Mflash777/starbiestonks/Renders/README.md

# Renders

- `schematic.png`, `schmaticsketch.jpeg`: the KiCad schematic and a sketch of it
- `kitcar2dfullpagepcb.jpeg`, `kitcar2dsmall.jpeg`: the routed PCB layout (2D)
- `kitcar3dviewgreenflat.jpeg`, `kitcarbirdseye.jpeg`: KiCad 3D viewer renders
