Mflash777/starbiestonks/BOM.md

# StarbieStonks – bill of materials

<!-- Generated by Half Life from project cmuwkw9wl08ms01oslrcru6od. Edits here are overwritten on the next sync. -->
<!-- Generated: 2026-10-12T04:02:59.856Z -->

> [!NOTE]
> This parts list is mirrored from [Half Life](https://halflife.hackclub.com). Editing it here will not change the platform's copy, and the next sync overwrites this file.

| Week | Tier | Parts funding |
| --- | --- | --- |
| Week 1 | Tier 2 | $65.00 |

| Part | What it's for | Qty | Unit | Total | Vendor |
| --- | --- | --- | --- | --- | --- |
| [XIAO ESP32-C3](https://www.seeedstudio.com/Seeed-XIAO-ESP32C3-p-5431.html) | Wi-Fi and the main loop | 1 | $4.99 | $4.99 | [Seeed Studio](https://www.seeedstudio.com/Seeed-XIAO-ESP32C3-p-5431.html) |
| [0.96 OLED (SSD1306 I2C)](https://www.amazon.com/dp/B0GBVWBWCR) | Shows the pet, menu, stats and stock screen | 1 | $9.99 | $9.99 | [Amazon](https://www.amazon.com/dp/B0GBVWBWCR) |
| [MPU6050](https://www.amazon.com/MPU-6050-Accelerometer-Gyroscope-Converter-Interface/dp/B0HDTWF4XQ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) | Detects tilt and shake to control the menu and pet reactions | 1 | $2.29 | $2.29 | [Amazon](https://www.amazon.com/MPU-6050-Accelerometer-Gyroscope-Converter-Interface/dp/B0HDTWF4XQ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) |
| [DHT11](https://www.amazon.com/Temperature-Humidity-Digital-3-3V-5V-Raspberry/dp/B07WT2HJ4F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) | Reads temperature and humidity for the stats screen | 1 | $5.99 | $5.99 | [Amazon](https://www.amazon.com/Temperature-Humidity-Digital-3-3V-5V-Raspberry/dp/B07WT2HJ4F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) |
| [MX Switches](https://www.amazon.com/Clicky-Mechanical-Keyboard-Switches-Tactile/dp/B0GX1XNZKB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) | Button 1 (menu / next ticker) and Button 2 (switch screens) | 1 | $4.99 | $4.99 | [Amazon](https://www.amazon.com/Clicky-Mechanical-Keyboard-Switches-Tactile/dp/B0GX1XNZKB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) |
| [Keycaps](https://www.amazon.com/Mechkeeb-Profile-Switches-Keyboard-Replacement/dp/B0BWDTBF1L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) | Caps for the two switches | 1 | $8.99 | $8.99 | [Amazon](https://www.amazon.com/Mechkeeb-Profile-Switches-Keyboard-Replacement/dp/B0BWDTBF1L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) |
| [10k Resistor](https://www.amazon.com/dp/B0B4JFPHTW) | Pull-up resistor for the DHT11 data line | 1 | $4.97 | $4.97 | [Amazon](https://www.amazon.com/dp/B0B4JFPHTW) |
| [PCB](https://www.jlcpcb.com/) | Custom board that holds and connects everything, made by JLCPCB | 1 | $5.30 | $5.30 | [JLCPCB](https://www.jlcpcb.com/) |
| [10PCS 2.54mm 40 Pin Breakaway Male Female Header Pins](https://www.amazon.com/Neprift-2-54mm-Breakaway-Female-Header/dp/B0GX55WYSX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) | to attach and detach parts so it is modular | 1 | $4.59 | $4.59 | [amazon](https://www.amazon.com/Neprift-2-54mm-Breakaway-Female-Header/dp/B0GX55WYSX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) |
| [passive buzzer](https://www.amazon.com/Shutao-12MMx8-5MM-Passive-Buzzer-Resistance/dp/B0GKNH6FPR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) | for sound | 1 | $5.99 | $5.99 | [amazon](https://www.amazon.com/Shutao-12MMx8-5MM-Passive-Buzzer-Resistance/dp/B0GKNH6FPR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) |
| **Parts subtotal** | — | — | — | **$58.09** | — |
| **Tax & shipping** | — | — | — | **$7.38** | — |
| **Total** | — | — | — | **$65.47** | — |

**$0.47 over the tier's funding.** Every tier gives a fixed amount for parts, so this needs cutting back or a higher tier.
