Mflash777/starbiestonks/BOM.csv

Item | Amount | Cost (ea.) | Total | Vendor | Link
XIAO ESP32-C3 | 1 | 4.99 | 4.99 | Seeed Studio | https://www.seeedstudio.com/Seeed-XIAO-ESP32C3-p-5431.html
0.96 OLED (SSD1306 I2C) | 1 | 9.99 | 9.99 | Amazon | https://www.amazon.com/dp/B0GBVWBWCR
MPU6050 | 1 | 2.29 | 2.29 | Amazon | https://www.amazon.com/dp/B0HDTWF4XQ
DHT11 | 1 | 5.99 | 5.99 | Amazon | https://www.amazon.com/dp/B07WT2HJ4F
MX Switches | 1 | 4.99 | 4.99 | Amazon | https://www.amazon.com/dp/B0GX1XNZKB
Keycaps | 1 | 8.99 | 8.99 | Amazon | https://www.amazon.com/dp/B0BWDTBF1L
10k Resistor | 1 | 4.97 | 4.97 | Amazon | https://www.amazon.com/dp/B0B4JFPHTW
PCB | 1 | 5.30 | 5.30 | JLCPCB | https://www.jlcpcb.com/
2.54mm 40-pin breakaway header pins (10 pcs) | 1 | 4.59 | 4.59 | Amazon | https://www.amazon.com/dp/B0GX55WYSX
Passive buzzer | 1 | 5.99 | 5.99 | Amazon | https://www.amazon.com/dp/B0GKNH6FPR
Parts subtotal |  |  | 58.09
Tax & shipping |  |  | 7.38
Total |  |  | 65.47
