Mflash777/starbiestonks/PCB/stonkstarbie.kicad_pcb

## KiCad design PCB/stonkstarbie.kicad_pcb (2026-10-11)

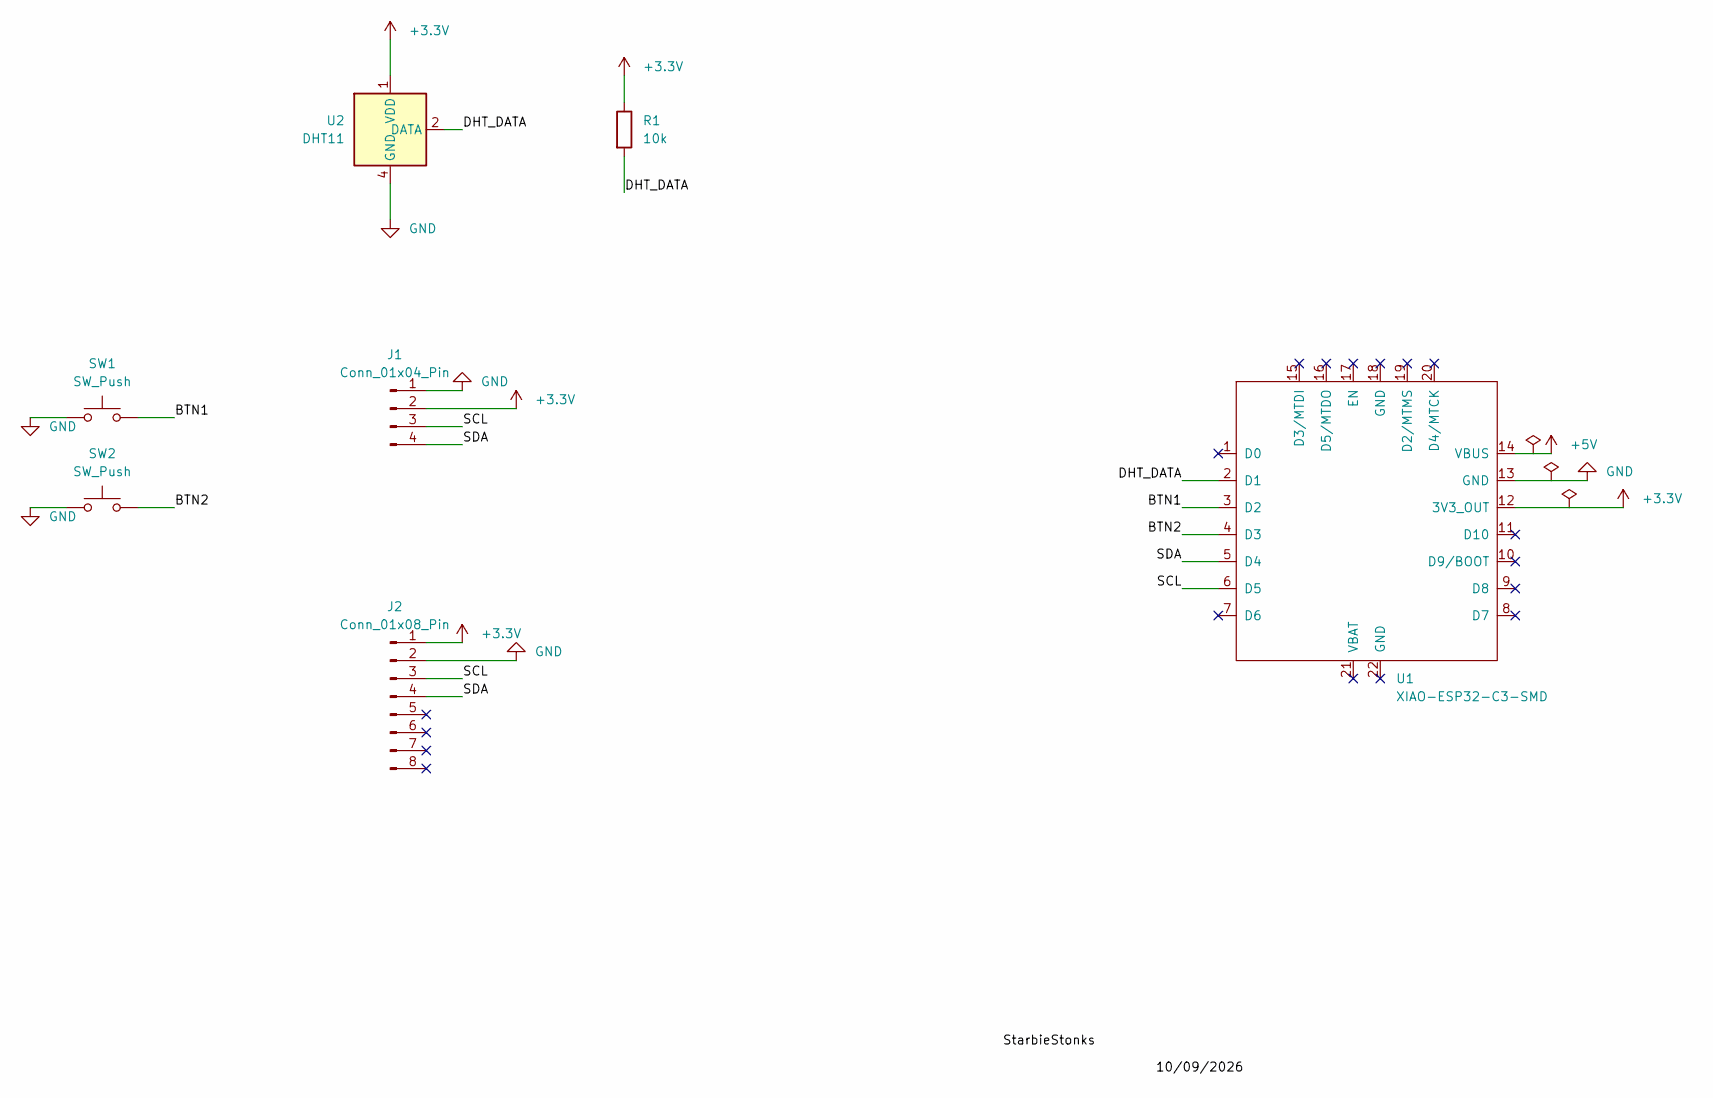
[picture p7: schematic stonkstarbie.kicad_sch]

Parts:
J1: Conn_01x04_Pin; PinHeader_1x04_P2.54mm_Vertical
J2: Conn_01x08_Pin; PinHeader_1x08_P2.54mm_Vertical
R1: 10k; R_0805_2012Metric
SW1, SW2: SW_Push; SW_Cherry_MX_1.00u_PCB
U1: XIAO-ESP32-C3-SMD
U2: DHT11; Aosong_DHT11_5.5x12.0_P2.54mm

Connections:
+3.3V: J1.2, J2.1, R1.1, U1.12 (3V3_OUT), U2.1 (VDD)
+5V: U1.14 (VBUS)
/BTN1: SW1.2, U1.3 (D2)
/BTN2: SW2.2, U1.4 (D3)
/DHT_DATA: R1.2, U1.2 (D1), U2.2 (DATA)
/SCL: J1.3, J2.3, U1.6 (D5)
/SDA: J1.4, J2.4, U1.5 (D4)
GND: J1.1, J2.2, SW1.1, SW2.1, U1.13 (GND), U2.4 (GND)

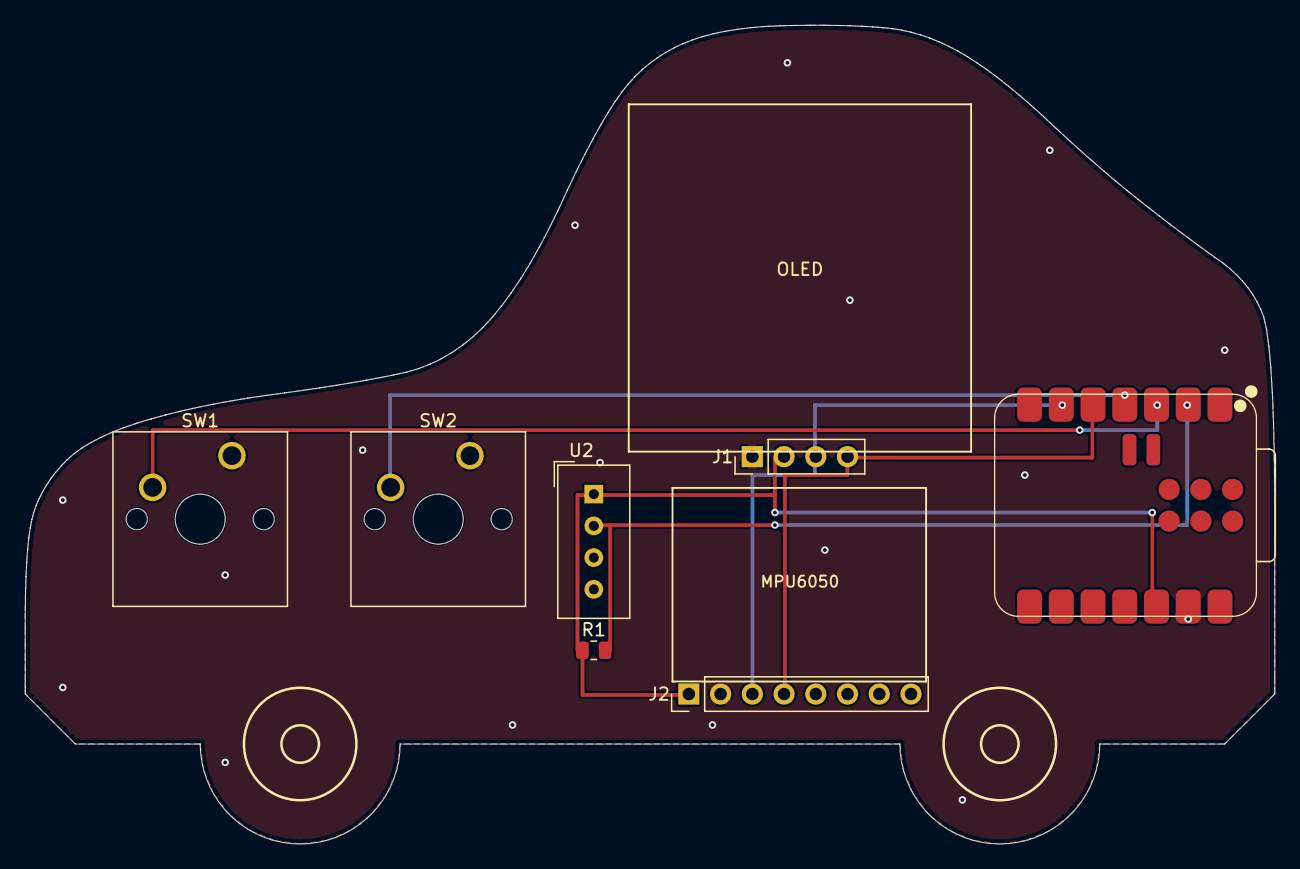
[picture p8: board stonkstarbie.kicad_pcb from above]

Board: 2 copper layers, 100.0 x 65.5 mm, 7 parts (0 on the bottom side), 7 nets.
