Mflash777/starbiestonks/(commit log)

2026-10-11 added all the files for pcb and gerbers as well as sketch
    [stonkstarbie-B_Cu.gbr, stonkstarbie-B_Mask.gbr, stonkstarbie-B_Paste.gbr, stonkstarbie-B_Silkscreen.gbr, stonkstarbie-Edge_Cuts.gbr, stonkstarbie-F_Cu.gbr, stonkstarbie-F_Mask.gbr, stonkstarbie-F_Paste.gbr]
2026-10-11 Organize repo: move Gerbers and PCB into PCB/, add .gitignore
    [stonkstarbie-B_Cu.gbr, stonkstarbie-B_Mask.gbr, stonkstarbie-B_Paste.gbr, stonkstarbie-B_Silkscreen.gbr, stonkstarbie-Edge_Cuts.gbr, stonkstarbie-F_Cu.gbr, stonkstarbie-F_Mask.gbr, stonkstarbie-F_Paste.gbr]
2026-10-11 add schematic and project file
    [stonkstarbie.kicad_sch]
2026-10-12 Update print statement from 'Hello' to 'Goodbye'
2026-10-20 Revise BOM with updated prices and new items
    Updated item prices and added new components with their costs.
    [BOM.csv]
2026-10-20 Fix BOM.csv formatting by removing empty trailing rows and keeping valid 6-column rows
    [BOM.csv]
